vladbelous/pcb-lab-3/pcb-lab-3-schematic.pdf

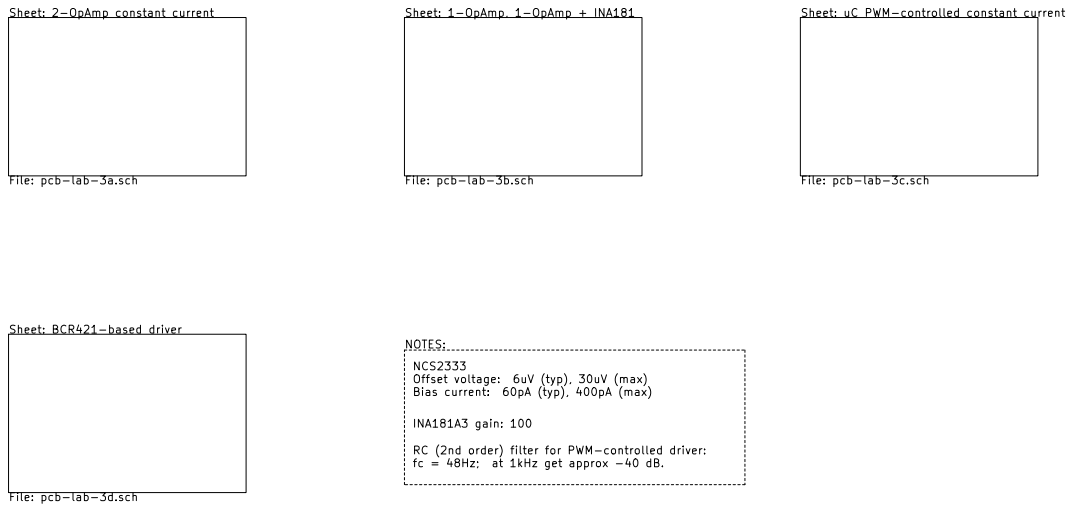
[picture p1: page 1]

Sheet: 2-OpAmp constant current

File: pcb-lab-3a.sch

Bias current: 60pA (typ), 400pA (max) NOTES:

RC (2nd order) filter for PWM-controlled driver:
fc = 48Hz; at 1kHz get approx -40 dB.

(C) Vlad Belous File: pcb-lab-3.sch Sheet: / CC BY-SA 4.0

Rev: | D Date: 2020-06-14 KiCad E.D.A. kicad 5.1.6 Size: USLetter

Id: 1/5 Title: PCB Lab 3

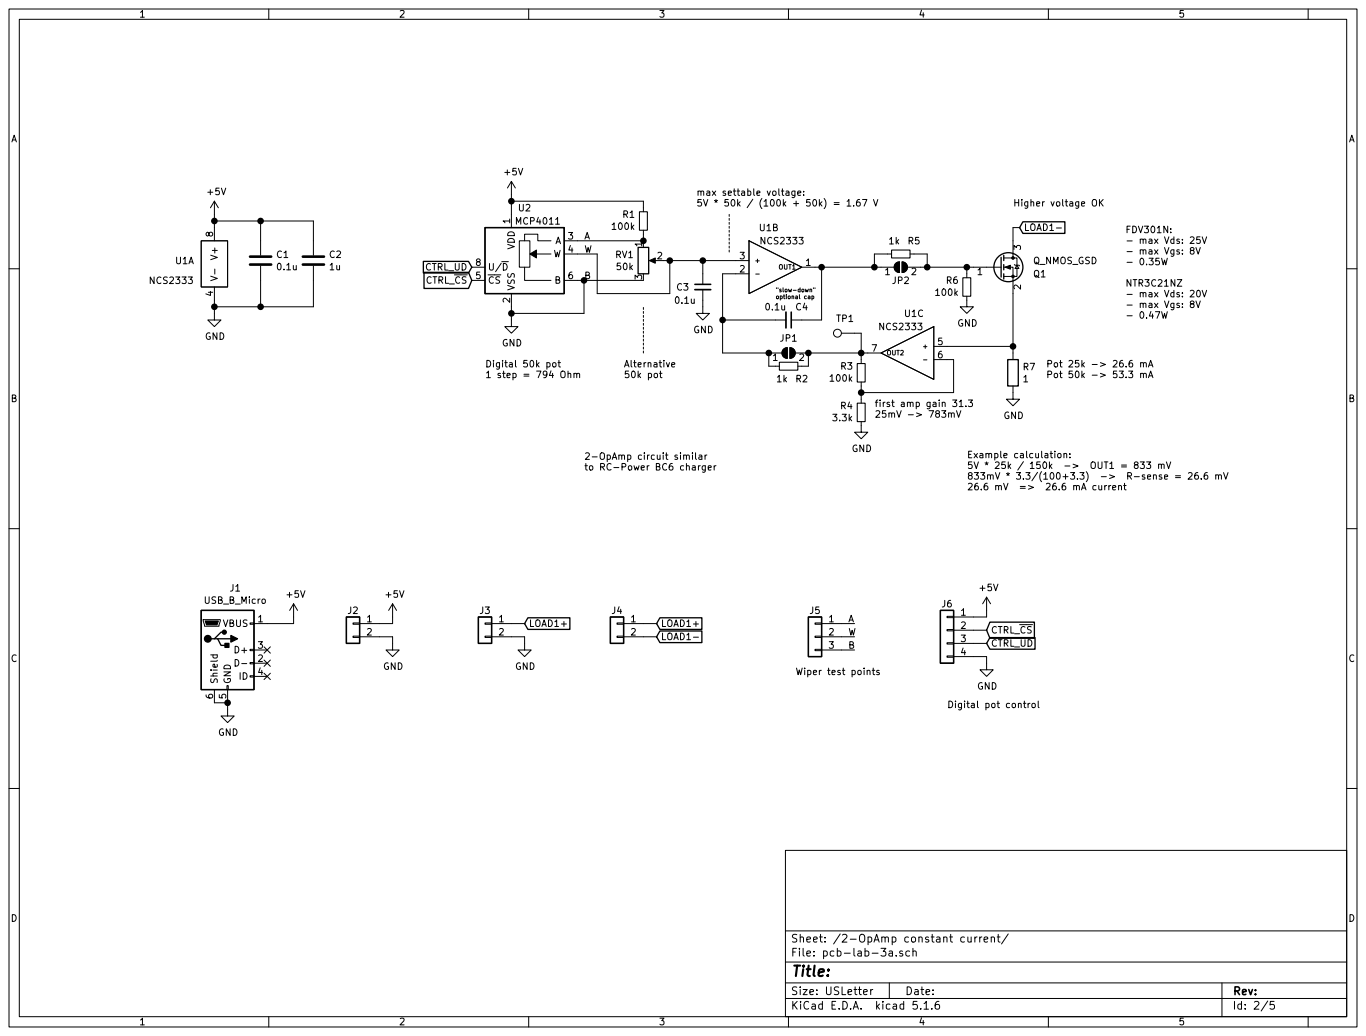
[picture p2: page 2]

26.6 mV => 26.6 mA current Digital 50k pot
1 step = 794 Ohm

2-OpAmp circuit similar
to RC-Power BC6 charger

File: pcb-lab-3a.sch
Id: 2/5 Title:

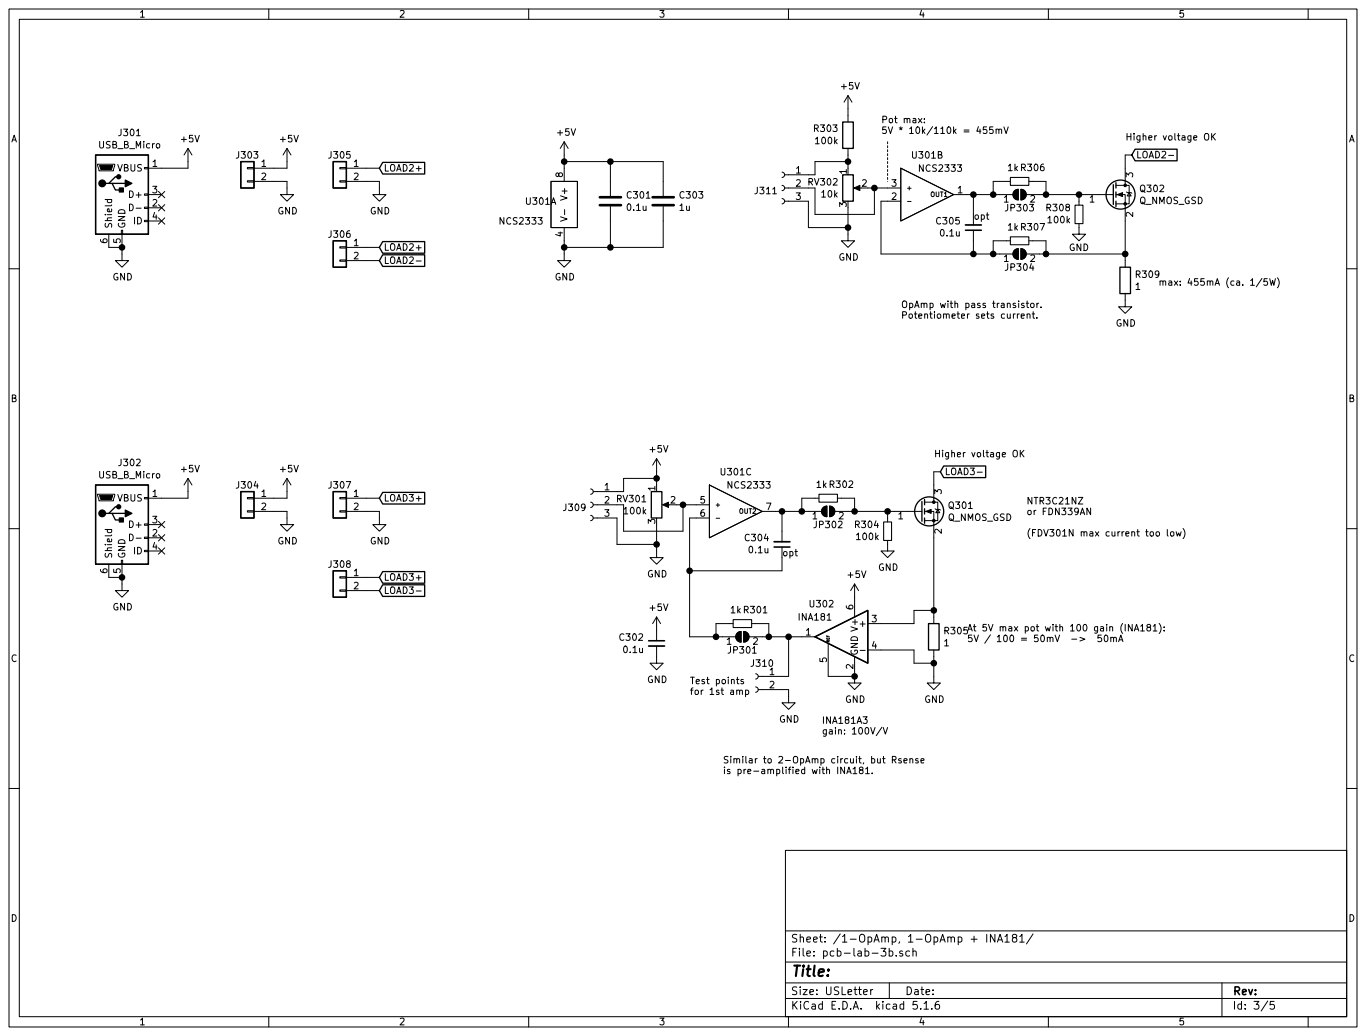
[picture p3: page 3]

opt OpAmp with pass transistor. Potentiometer sets current. Similar to 2-OpAmp circuit, but Rsense

(FDV301N max current too low)

is pre-amplified with INA181.

Sheet: /1-OpAmp, 1-OpAmp + INA181/
File: pcb-lab-3b.sch
Id: 3/5 Title:

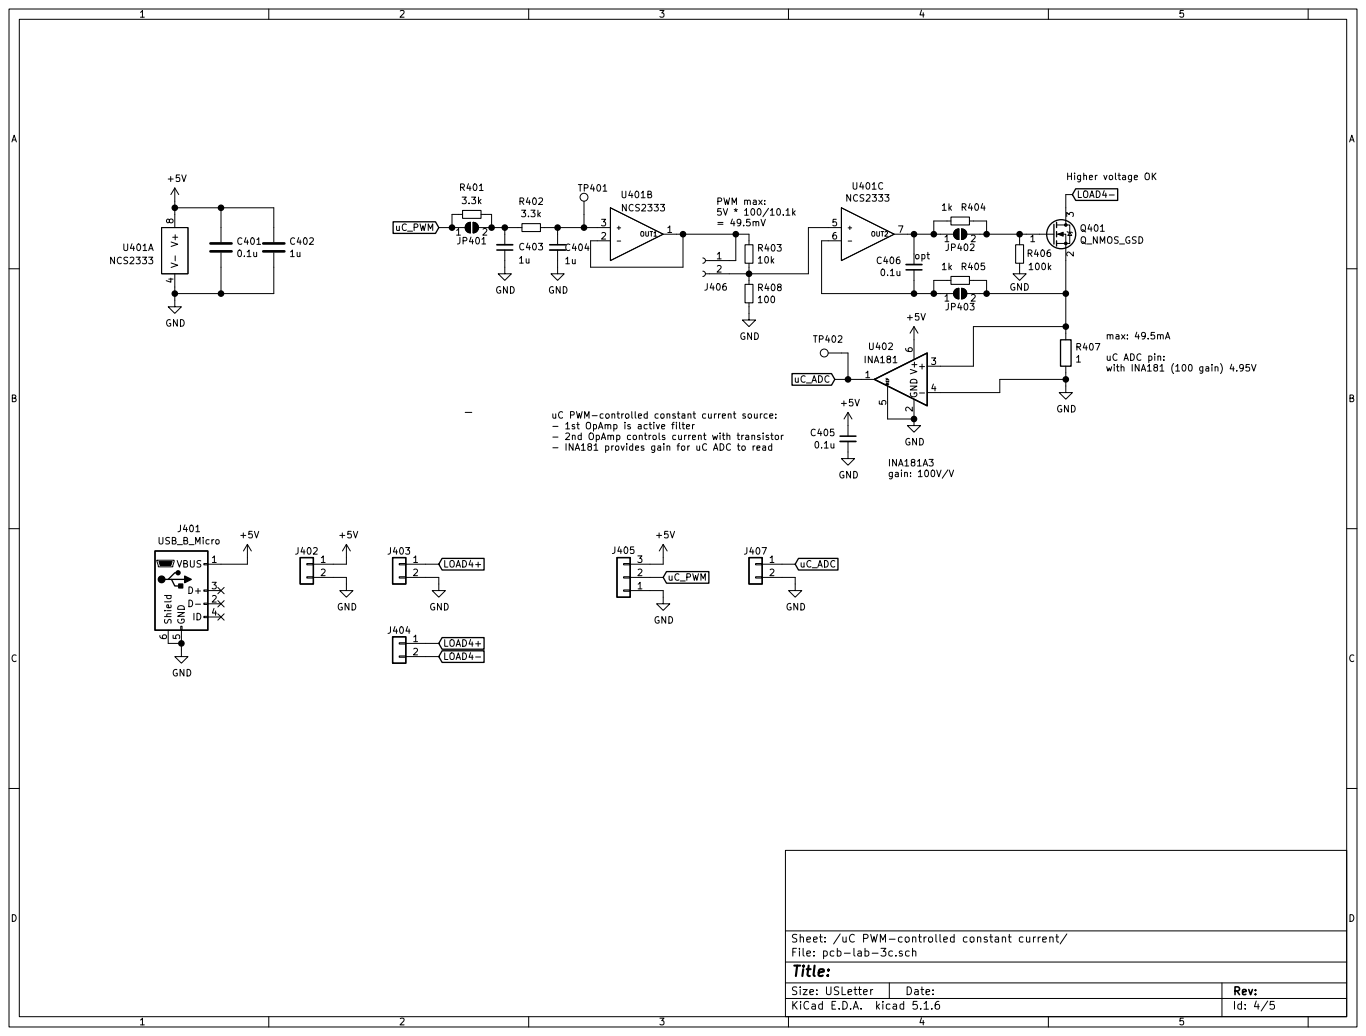
[picture p4: page 4]

Higher voltage OK max: 49.5mA

opt uC PWM-controlled constant current source: - 1st OpAmp is active filter

- 2nd OpAmp controls current with transistor
- INA181 provides gain for uC ADC to read

File: pcb-lab-3c.sch Sheet: /uC PWM-controlled constant current/

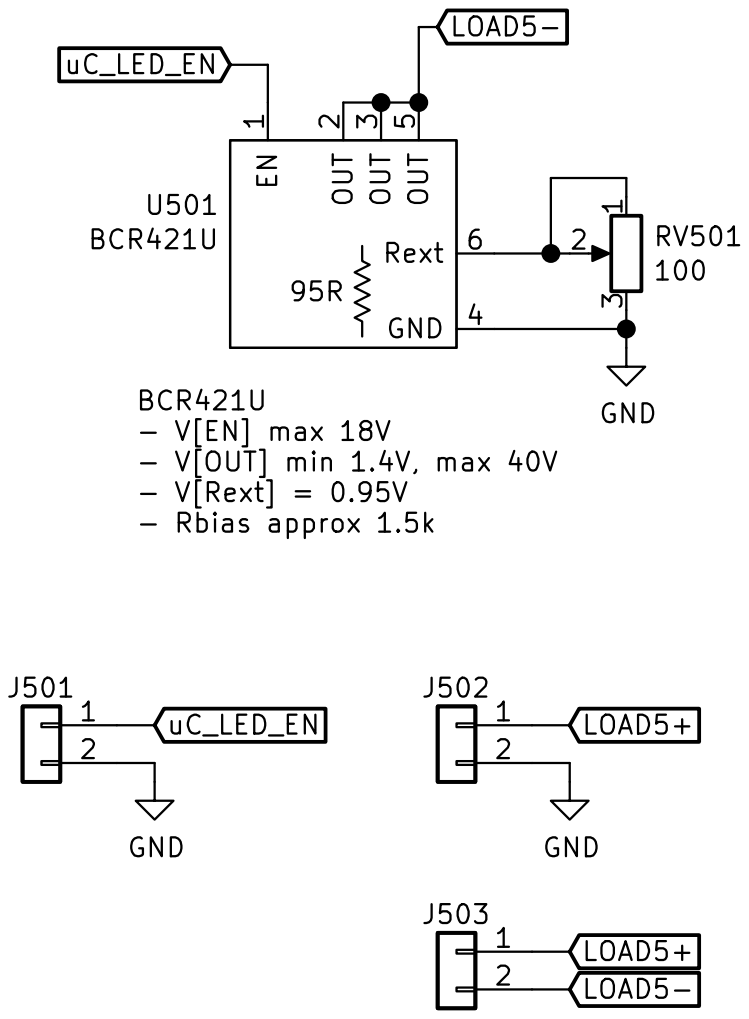
[picture p5: page 5]

LOAD5- BCR421U
uC_LED_EN
File: pcb-lab-3d.sch Sheet: /BCR421-based driver/ GND
