vladbelous/pcb-lab-3/pcb-lab-3-layout.pdf

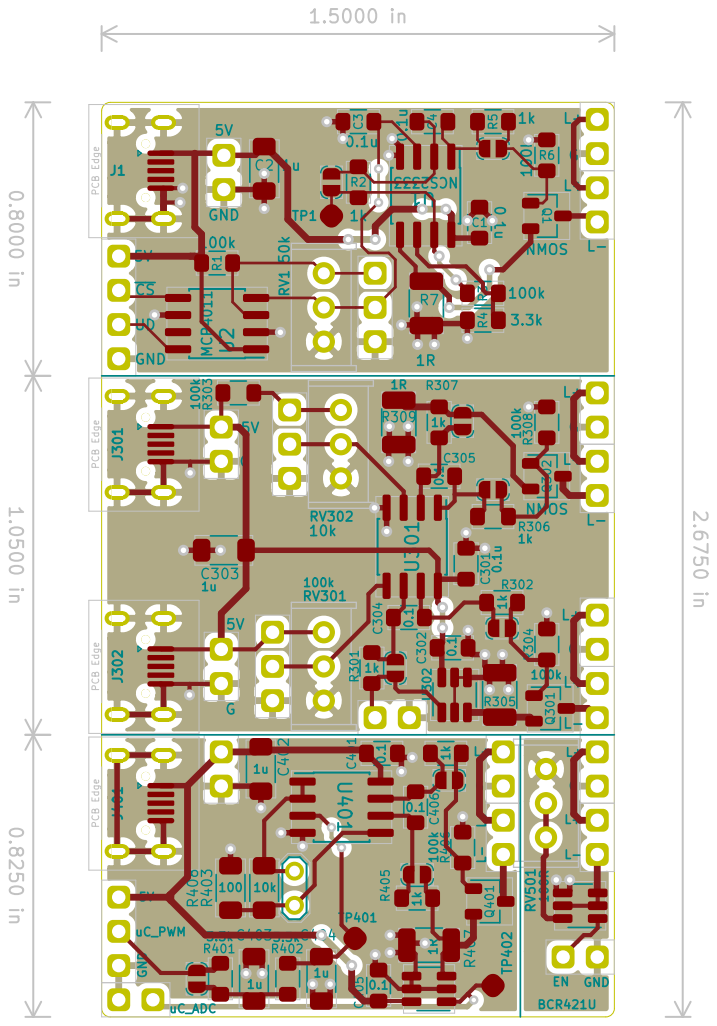
[picture p6: page 1]
