vladbelous/pcb-lab-3/pcb-lab-3.kicad_pcb

## KiCad design pcb-lab-3.kicad_pcb (2020-07-21)

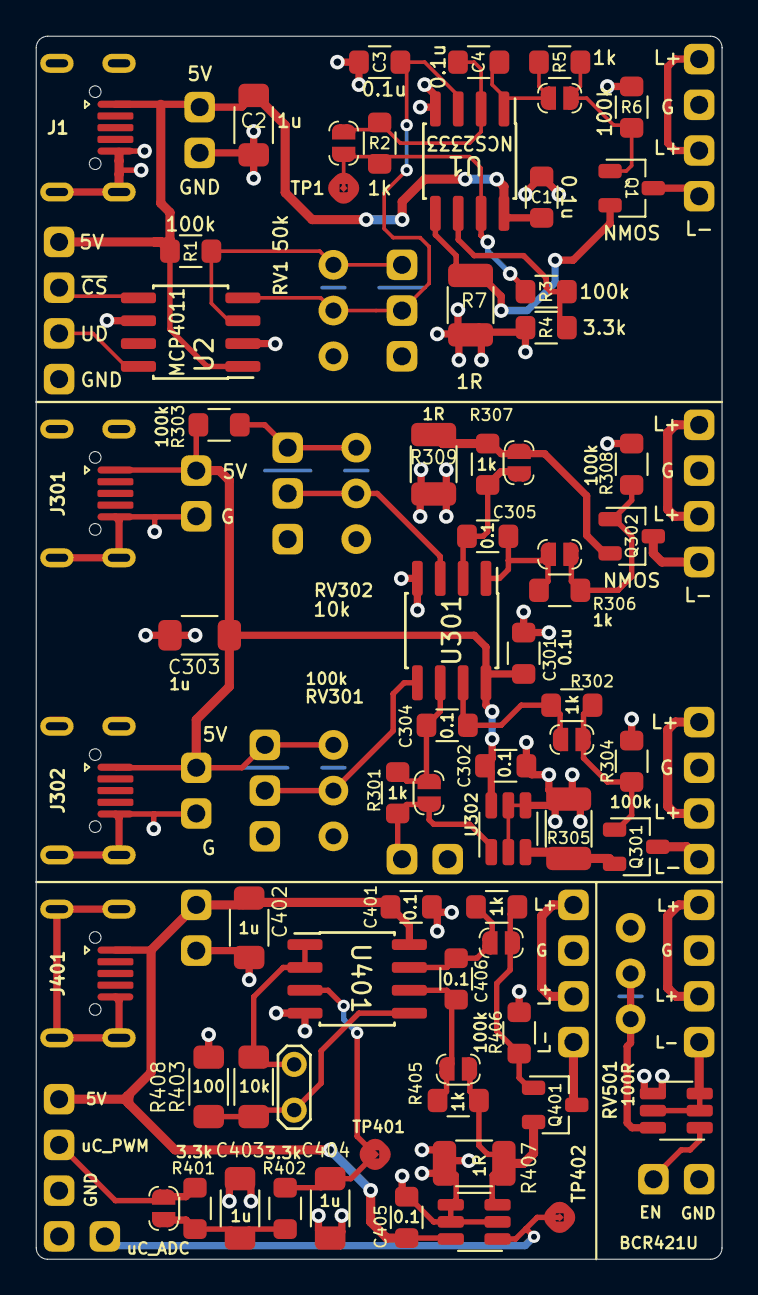
[picture p7: board pcb-lab-3.kicad_pcb from above]

Board: 2 copper layers, 38.1 x 67.9 mm, 93 parts (0 on the bottom side), 46 nets.

Parts:
C1, C3, C4, C301, C302, C304, C305, C401, C405, C406: 0.1u; 0805_HS
C2, C303, C402, C403, C404: 1u; 1206_HS
J1, J301, J302, J401: USB_B_Micro; USB-micro-B_4-legs_Banggood
J2, J3, J4, J303, J304, J305, J306, J307, J308, J402, J403, J404, J407, J501, J502, J503: Conn_01x02; Pin_Header_Straight_1x02_Pitch2.54mm
J5, J405: Conn_01x03; Pin_Header_Straight_1x03_Pitch2.54mm
J6: Conn_01x04; Pin_Header_Straight_1x04_Pitch2.54mm
J309, J311: Conn_01x03_Female; Pin_Header_Straight_1x03_Pitch2.54mm
J310: Conn_01x02_Female; Pin_Header_Straight_1x02_Pitch2.54mm
J406: Conn_01x02_Female; TestPoint_2Pads_Pitch2.54mm_Drill0.8mm
JP1, JP2, JP301, JP302, JP303, JP304, JP401, JP402, JP403: SolderJumper_2_Open; SolderJumper-2_P1.3mm_Open
Q1, Q301, Q302, Q401: Q_NMOS_GSD; SOT-23_HS
R1, R3, R6, R303, R304, R308, R406: 100k; 0805_HS
R2, R5, R301, R302, R306, R307, R404, R405: 1k; 0805_HS
R4, R401, R402: 3.3k; 0805_HS
R7, R305, R309, R407: 1; 1210_HS
R403: 10k; 1206_HS
R408: 100; 1206_HS
RV1: 50k; RV-Pot_3-pin_2.54mm
RV301: 100k; RV-Pot_3-pin_2.54mm
RV302: 10k; RV-Pot_3-pin_2.54mm
RV501: 100; RV-Pot_3-pin_2.54mm
TP1, TP401, TP402: TestPoint; SMD-TestPoint_01x01
U1, U301, U401: NCS2333; SOIC-8_3.9x4.9mm_Pitch1.27mm_HS
U2: MCP4011; SOIC-8_3.9x4.9mm_Pitch1.27mm_HS
U302, U402: INA181; SOT-23-6_HS
U501: BCR421U; SOT-23-6_HS

Connections:
+5V: C1.1, C2.1, C301.1, C302.1, C303.1, C401.1, C402.1, C405.1, J1.1, J2.1, J6.1, J301.1, J302.1, J303.1, J304.1, J309.1, J401.1, J402.1, J405.3, R1.2, R303.2, RV301.1, U1.8, U2.1, U301.8, U302.6, U401.8, U402.6
/2-OpAmp constant current/A: J5.1, R1.1, RV1.1, U2.3
/2-OpAmp constant current/W: C3.1, J5.2, RV1.2, U1.3, U2.4
CTRL_UD: J6.3, U2.8
CTRL_~CS: J6.2, U2.5
GND: C1.2, C2.2, C3.2, C301.2, C302.2, C303.2, C401.2, C402.2, C403.1, C404.2, C405.2, J1.5, J1.6, J2.2, J3.2, J5.3, J6.4, J301.5, J301.6, J302.5, J302.6, J303.2, J304.2, J305.2, J307.2, J309.3, J310.2, J311.3, J401.5, J401.6, J402.2, J403.2, J405.1, J407.2, J501.2, J502.2, R4.1, R6.1, R7.2, R304.1, R305.2, R308.1, R309.2, R406.1, R407.2, R408.2, RV1.3, RV301.3, RV302.3, RV501.3, U1.4, U2.2, U2.6, U301.4, U302.2, U302.4, U302.5, U401.4, U402.2, U402.4, U402.5, U501.4
LOAD1+: J3.1, J4.1
LOAD1-: J4.2, Q1.3
LOAD2+: J305.1, J306.1
LOAD2-: J306.2, Q302.3
LOAD3+: J307.1, J308.1
LOAD3-: J308.2, Q301.3
LOAD4+: J403.1, J404.1
LOAD4-: J404.2, Q401.3
LOAD5+: J502.1, J503.1
LOAD5-: J503.2, U501.2, U501.3, U501.5
unnamed: C4.1, JP2.1, R5.2, U1.1
unnamed: C4.2, JP1.1, R2.2, U1.2
unnamed: C304.1, JP301.1, R301.2, U301.6
unnamed: C304.2, JP302.1, R302.2, U301.7
unnamed: C305.1, JP304.1, R307.2, U301.2
unnamed: C305.2, JP303.1, R306.2, U301.1
unnamed: C403.2, JP401.2, R401.1, R402.2
unnamed: C404.1, R402.1, TP401.1, U401.3
unnamed: C406.1, JP403.1, R405.2, U401.6
unnamed: C406.2, JP402.1, R404.2, U401.7
unnamed: J309.2, RV301.2, U301.5
unnamed: J310.1, JP301.2, R301.1, U302.1
unnamed: J311.1, R303.1, RV302.1
unnamed: J311.2, RV302.2, U301.3
unnamed: J406.1, R403.1, U401.1, U401.2
unnamed: J406.2, R403.2, R408.1, U401.5
unnamed: JP1.2, R2.1, R3.2, TP1.1, U1.7
unnamed: JP2.2, Q1.1, R5.1, R6.2
unnamed: JP302.2, Q301.1, R302.1, R304.2
unnamed: JP303.2, Q302.1, R306.1, R308.2
unnamed: JP304.2, Q302.2, R307.1, R309.1
unnamed: JP402.2, Q401.1, R404.1, R406.2
unnamed: JP403.2, Q401.2, R405.1, R407.1, U402.3
unnamed: Q1.2, R7.1, U1.5
unnamed: Q301.2, R305.1, U302.3
unnamed: R3.1, R4.2, U1.6
unnamed: RV501.1, RV501.2, U501.6
uC_ADC: J407.1, TP402.1, U402.1
uC_LED_EN: J501.1, U501.1
uC_PWM: J405.2, JP401.1, R401.2
