vladbelous/pcb-lab-3/(commit log)

2020-06-28 Initial commit. Constant current sourcing: 4 different circuits
    [pcb-lab-3.kicad_pcb, pcb-lab-3.sch]
2020-06-30 Split into hierarchical sheets. Work on 1st circuit
    [pcb-lab-3.sch, pcb-lab-3a.sch, pcb-lab-3b.sch, pcb-lab-3c.sch]
2020-06-30 Add connectors to all circuits
    [pcb-lab-3.sch, pcb-lab-3b.sch, pcb-lab-3c.sch]
2020-07-01 Voltage divider values and current sense ranges
    [pcb-lab-3a.sch, pcb-lab-3b.sch, pcb-lab-3c.sch]
2020-07-02 Gate pull-down to GND instead of source
    [pcb-lab-3.sch, pcb-lab-3a.sch, pcb-lab-3b.sch, pcb-lab-3c.sch]
2020-07-02 Add BCR421U symbol and circuit sheet
    [pcb-lab-3.sch, pcb-lab-3a.sch, pcb-lab-3b.sch, pcb-lab-3c.sch, pcb-lab-3d.sch]
2020-07-15 Schematic work: RC filter values
    [pcb-lab-3.sch, pcb-lab-3c.sch]
2020-07-17 Adjust usb-micro pads for easier soldering
2020-07-17 Annotate schematic and generate netlist
    [pcb-lab-3a.sch, pcb-lab-3b.sch, pcb-lab-3c.sch, pcb-lab-3d.sch]
2020-07-17 Init PCB file and setup design rules
    [pcb-lab-3.kicad_pcb]
2020-07-17 Approx layout of 1st circuit
    [pcb-lab-3.kicad_pcb]
2020-07-17 Approx layout of all components / all circuits
    [pcb-lab-3.kicad_pcb]
2020-07-18 Tune footprints, reimport netlist
    [pcb-lab-3.kicad_pcb, pcb-lab-3a.sch, pcb-lab-3b.sch, pcb-lab-3c.sch, pcb-lab-3d.sch]
2020-07-18 Complete routing (except GND) of 1st circuit
    [pcb-lab-3.kicad_pcb, pcb-lab-3a.sch]
2020-07-19 Tuned layout of 2nd circuit
    [pcb-lab-3.kicad_pcb]
2020-07-19 Complete routing (-GND) of 2nd circuit
    [pcb-lab-3.kicad_pcb]
2020-07-20 Tune layout of 3rd and 4th circuits
    [pcb-lab-3.kicad_pcb]
2020-07-20 Remove potentiometer from PWM circuit
    [pcb-lab-3.kicad_pcb, pcb-lab-3c.sch]
2020-07-20 Complete routing (-GND) of 3rd an 4th circuits
    [pcb-lab-3.kicad_pcb]
2020-07-21 Ground vias
    [pcb-lab-3.kicad_pcb]
2020-07-21 Minor tuning
    [pcb-lab-3.kicad_pcb]
2020-07-21 Top and bottom silkscreen
    [pcb-lab-3.kicad_pcb]
2020-07-21 Schematic and layout pdfs
    [pcb-lab-3d.sch]
